SVeilleux9/PDM/Hardware/d37858e919973864552352d870b846dc16fe7653.step

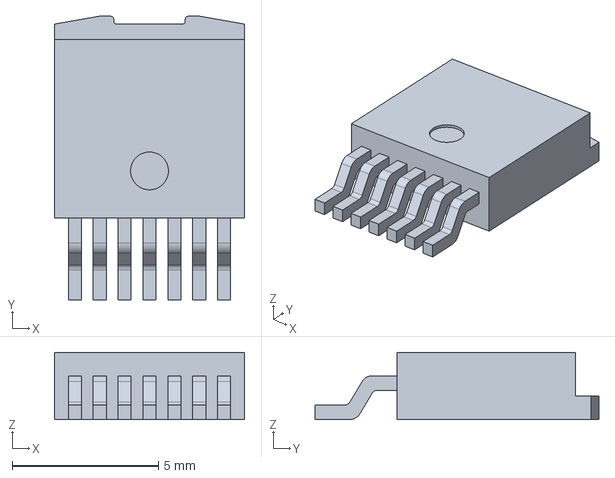
[picture p1: CAD file, 2020-03-28]
Hardware/d37858e919973864552352d870b846dc16fe7653.step
6.50 x 9.70 x 2.30 mm
