SVeilleux9/PDM/(threads)

Thread 3 (2020-04-06):

Add Temperature Sensor

SVeilleux9, 2020-04-06:
Due to concerns of the 6 high current outputs getting really hot. A temperature sensor may be a good idea.
