SVeilleux9/PDM/(commit log)

2020-04-08 Started updating PCB layout for new MCU. Started changing PSU circuit to a JLC friendly design.
    [Input.sch, Output.sch, mcu.sch, psu.sch, rusPDM.kicad_pcb, rusPDM.sch]
2020-04-09 Mostly routed. Still need to add the TI buck converter as backup.
    [Input.sch, Output.sch, mcu.sch, psu.sch, rusPDM.kicad_pcb]
2020-04-09 Before I forget I tied the !OE1/2 to GND. Always enabled.
    [Input.sch, mcu.sch]
2020-04-10 example of flyback diodes.
    [rusPDM.kicad_pcb]
2020-04-10 Mostly finished routing.
    Finished routing and adding fill areas.
    Need to:
    Connect CAN to TE connector.
    Add TI buck converter for backup.
    Add lots of vias for thermals.
    Add temperature sensor (?)
    [Input.sch, Output.sch, mcu.sch, psu.sch, rusPDM.kicad_pcb, rusPDM.sch]
2020-10-29 Started the re-route
    So many lines of resistors. 24 inputs of 3 - 0604 packages, 22 outputs with 3 - 0604 packages. That gives 138 - 0604 parts just for IO stuff.
    [rusPDM-B_Cu.gbr, rusPDM-B_Mask.gbr, rusPDM-B_Paste.gbr, rusPDM-B_SilkS.gbr, rusPDM-Edge_Cuts.gbr, rusPDM-F_Cu.gbr, rusPDM-F_Mask.gbr, rusPDM-F_Paste.gbr]
2020-11-03 board layout progress
    [rusPDM.kicad_pcb]
2020-11-08 V2 of the board is 99% done
    Might change some parts around to reduce BOM cost. But this is about 99% done.
    [Input.sch, Output.sch, mcu.sch, psu.sch, rusPDM-BOM.csv, rusPDM.kicad_pcb, rusPDM.sch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]
